craigyjp/trilogy-programmer/Photos/20190617_203137.jpg

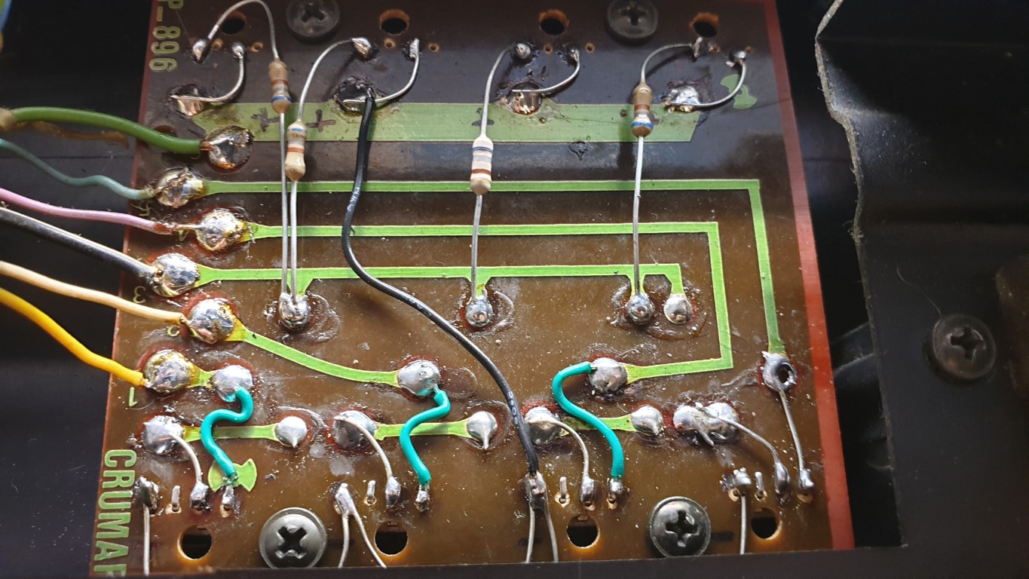
Photos/20190617_203137.jpg
