craigyjp/trilogy-programmer/Photos/20190617_203951.jpg

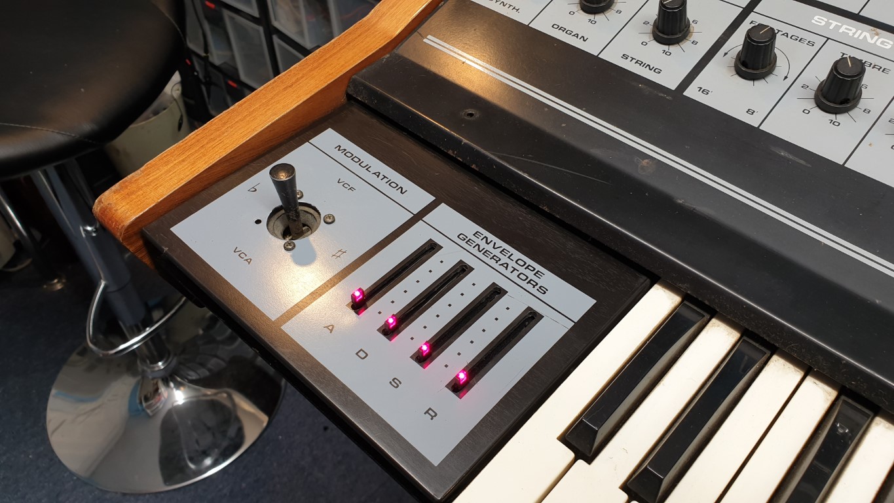
Photos/20190617_203951.jpg
