craigyjp/trilogy-programmer/Photos/20190617_203955.jpg

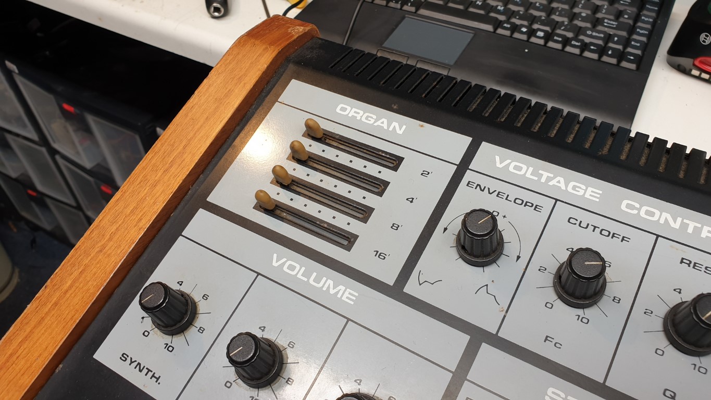
Photos/20190617_203955.jpg
