craigyjp/trilogy-programmer/Photos/20190617_230152.jpg

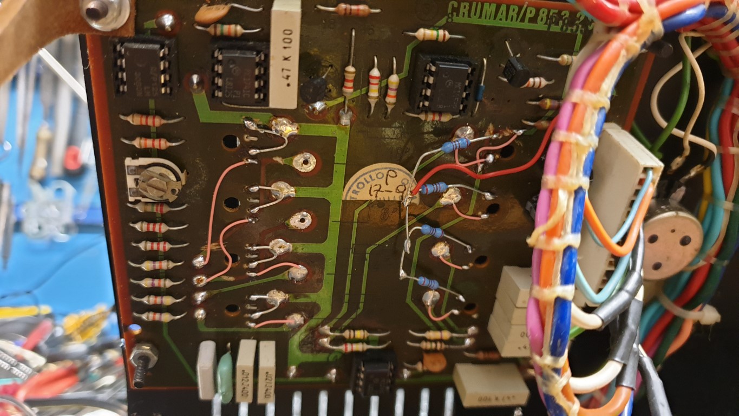
Photos/20190617_230152.jpg
