craigyjp/trilogy-programmer/Photos/20190617_230740.jpg

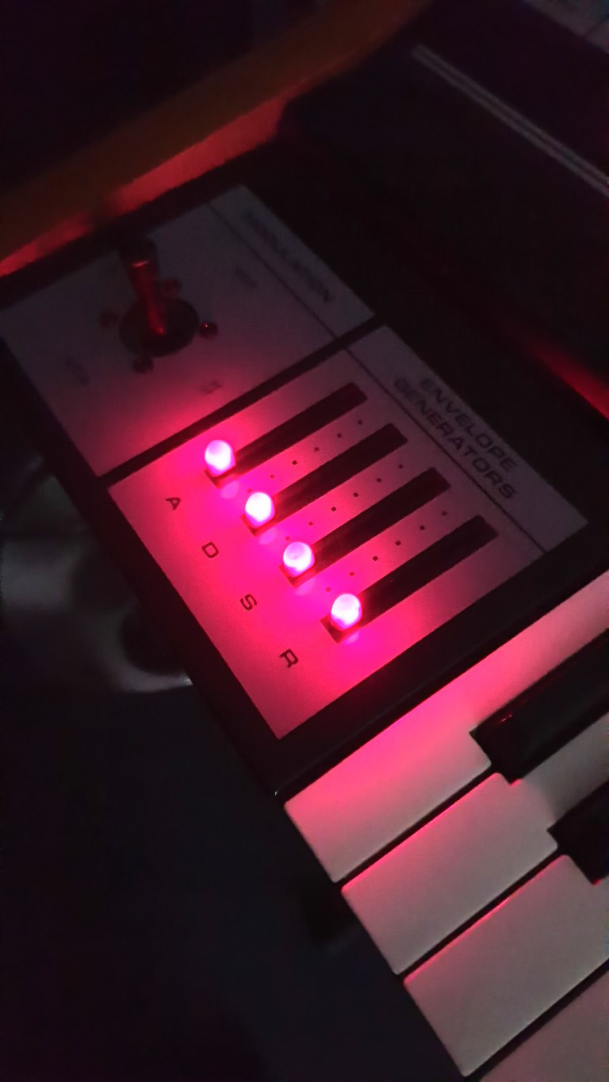
Photos/20190617_230740.jpg
