craigyjp/trilogy-programmer/Photos/20201019_152127.jpg

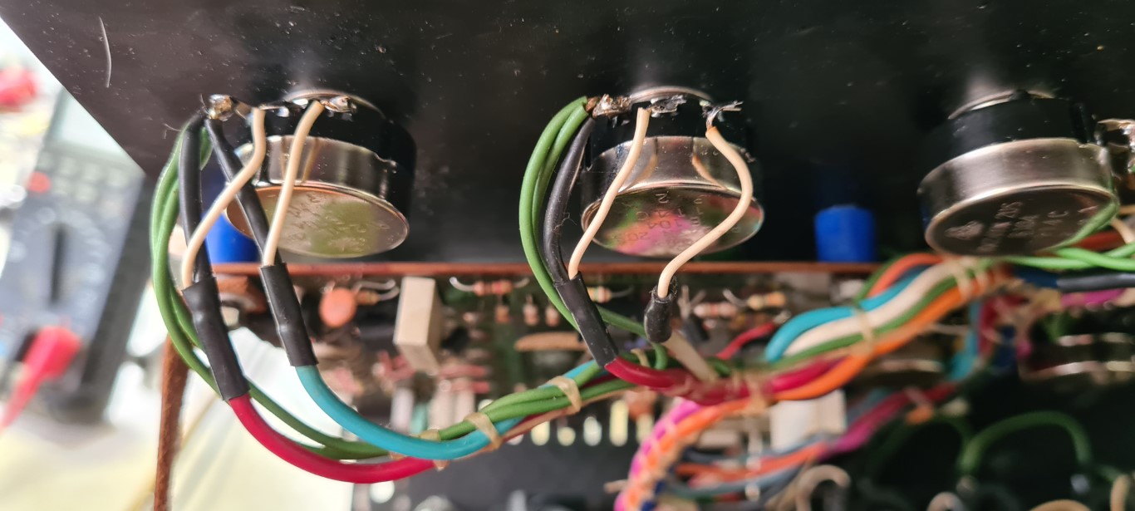
Photos/20201019_152127.jpg
