craigyjp/trilogy-programmer/Photos/20230502_165829.jpg

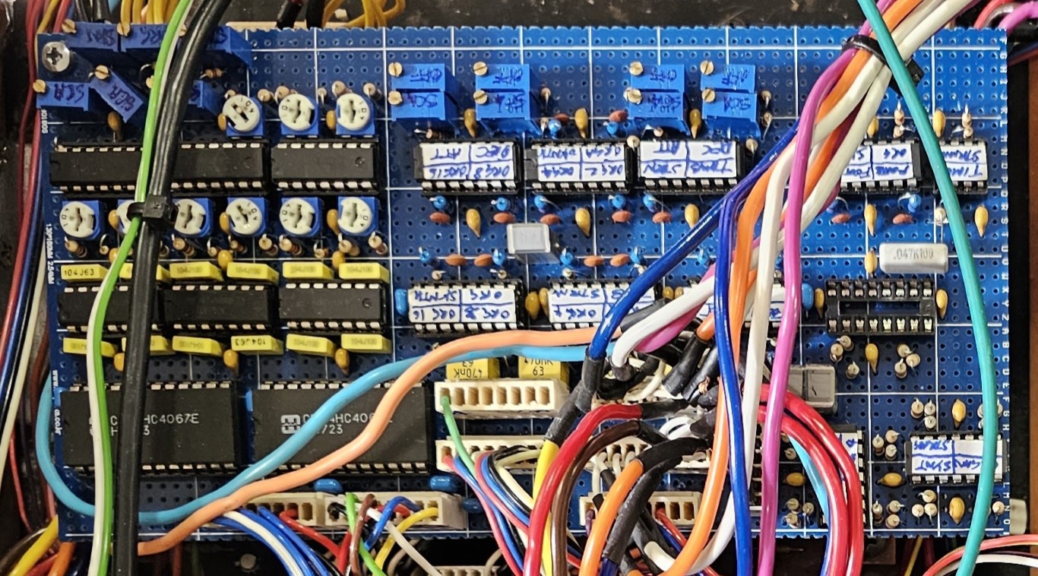
Photos/20230502_165829.jpg
