craigyjp/trilogy-programmer/Photos/20230504_145006.jpg

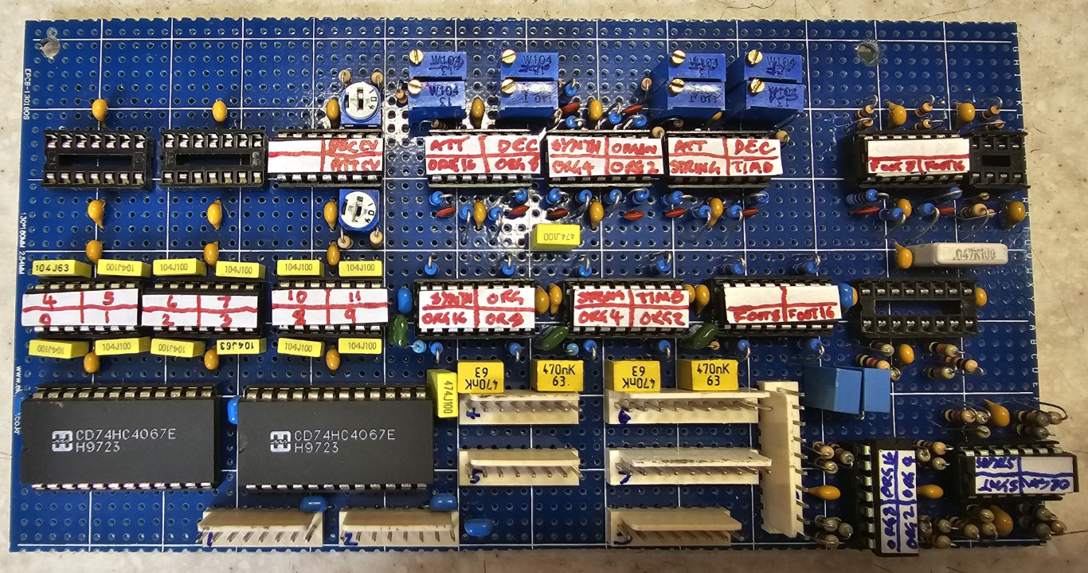
Photos/20230504_145006.jpg
