craigyjp/trilogy-programmer/Photos/20230504_152907.jpg

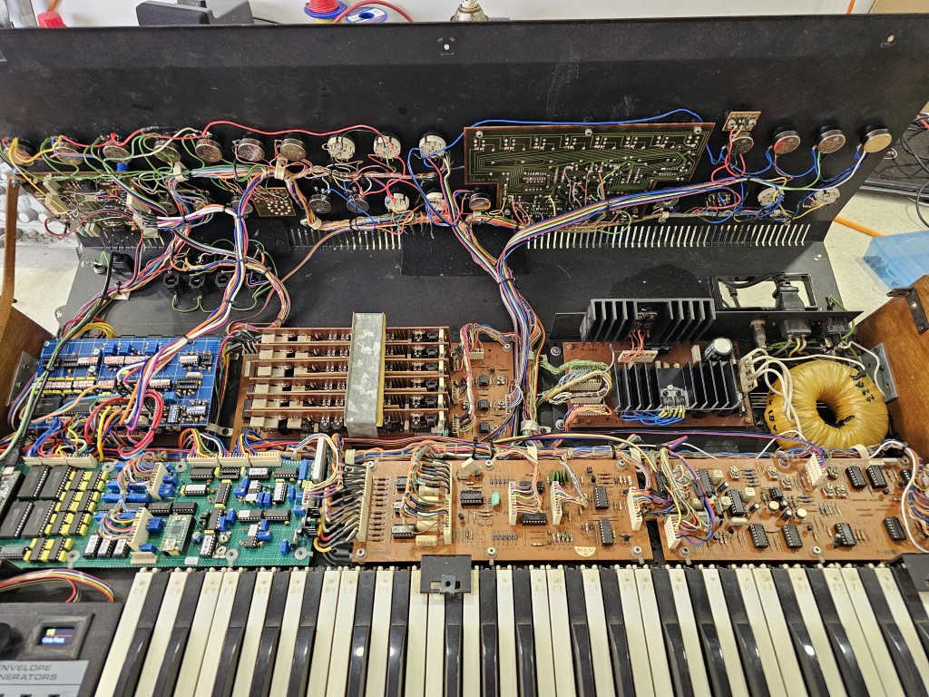
Photos/20230504_152907.jpg
