craigyjp/trilogy-programmer/Photos/20230506_184149.jpg

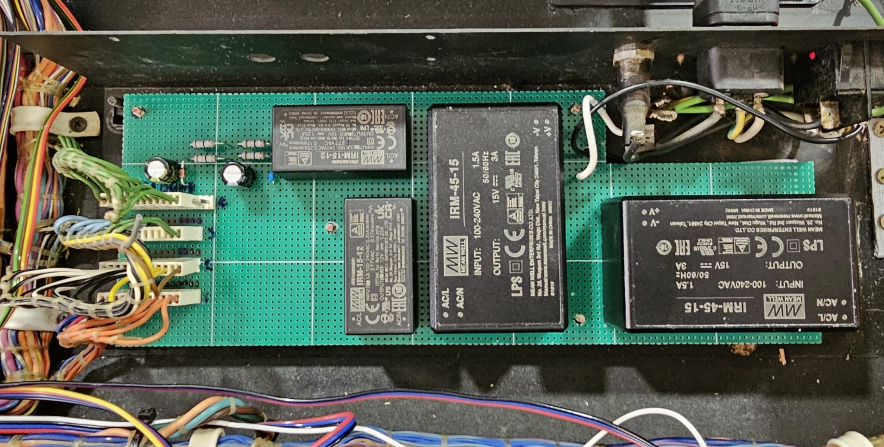
Photos/20230506_184149.jpg
