craigyjp/trilogy-programmer/Photos/20231115_115613.jpg

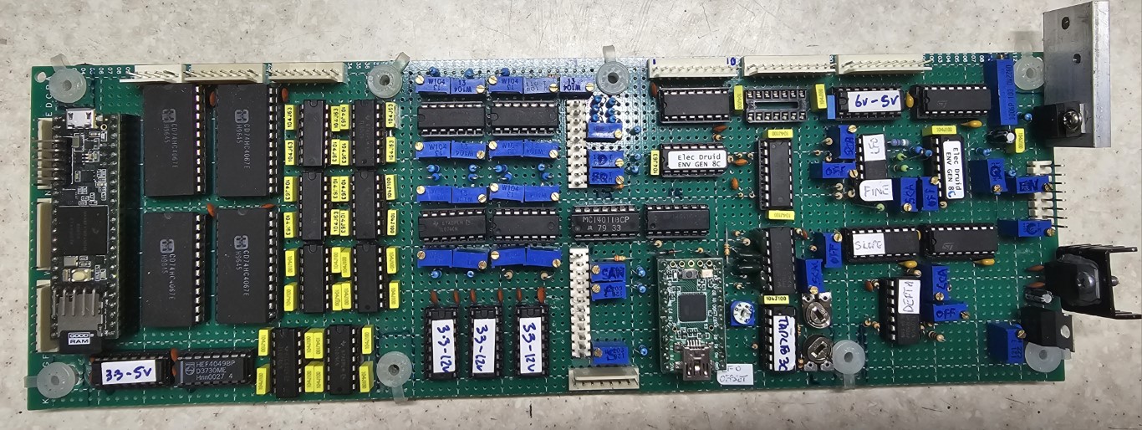
Photos/20231115_115613.jpg
