craigyjp/trilogy-programmer/Photos/20231115_134239.jpg

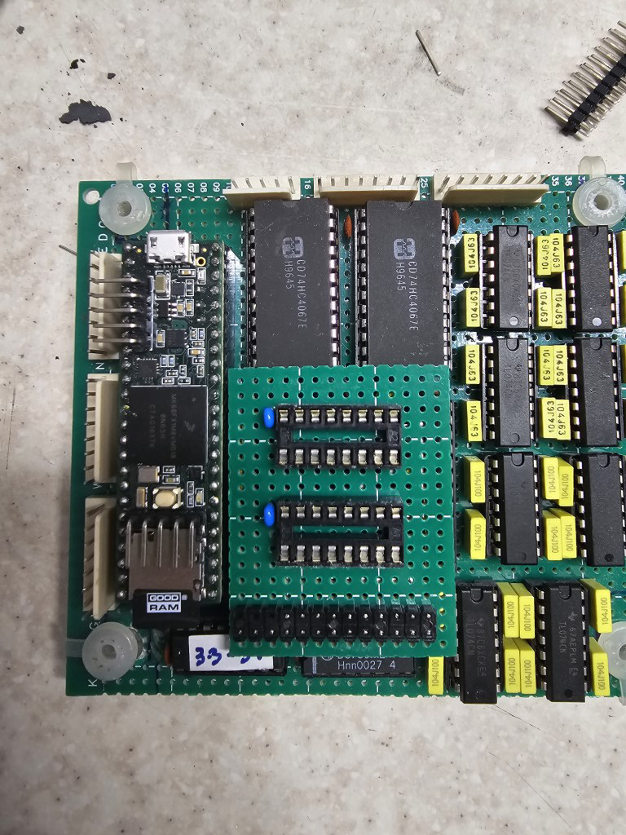
Photos/20231115_134239.jpg
