craigyjp/trilogy-programmer/Photos/20231115_134432.jpg

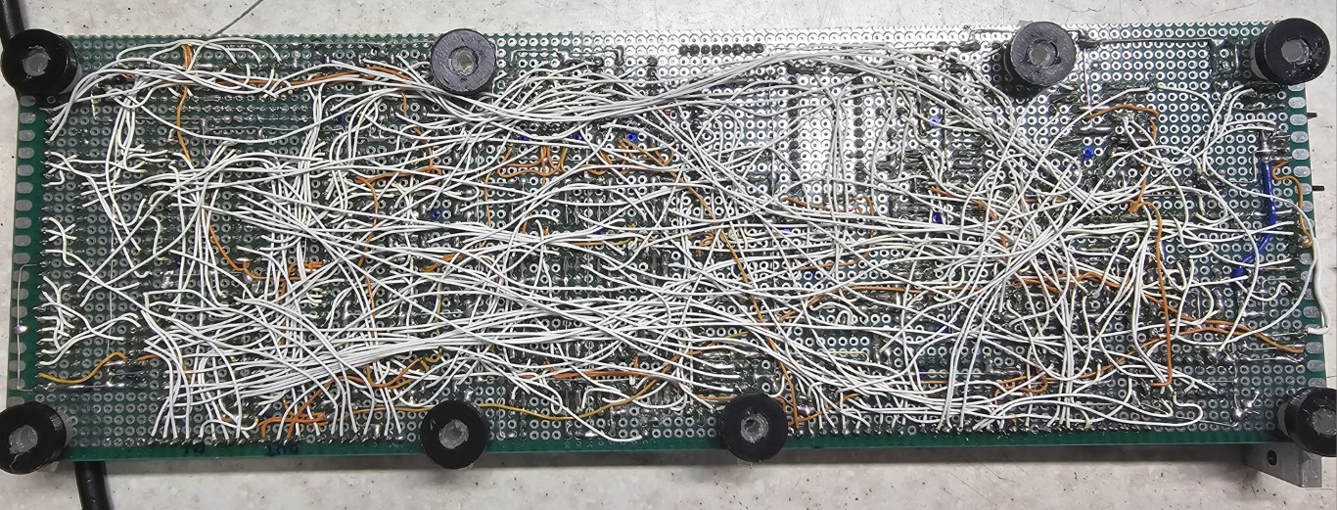
Photos/20231115_134432.jpg
