craigyjp/trilogy-programmer/Photos/20231115_145547.jpg

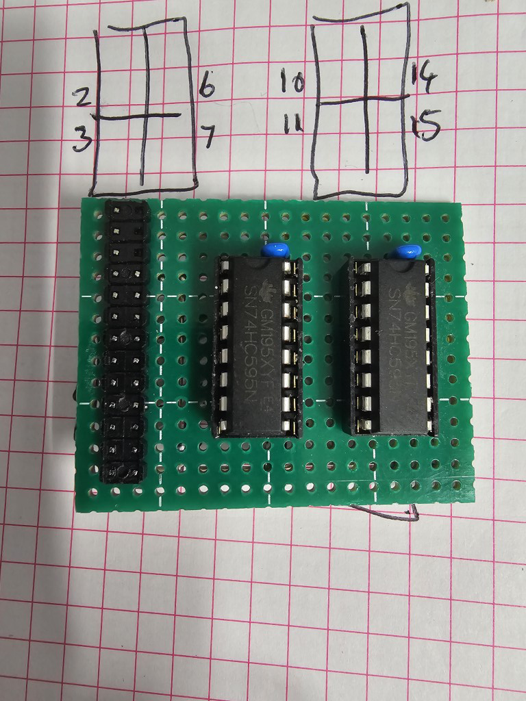
Photos/20231115_145547.jpg
