craigyjp/trilogy-programmer/Photos/20231115_145554.jpg

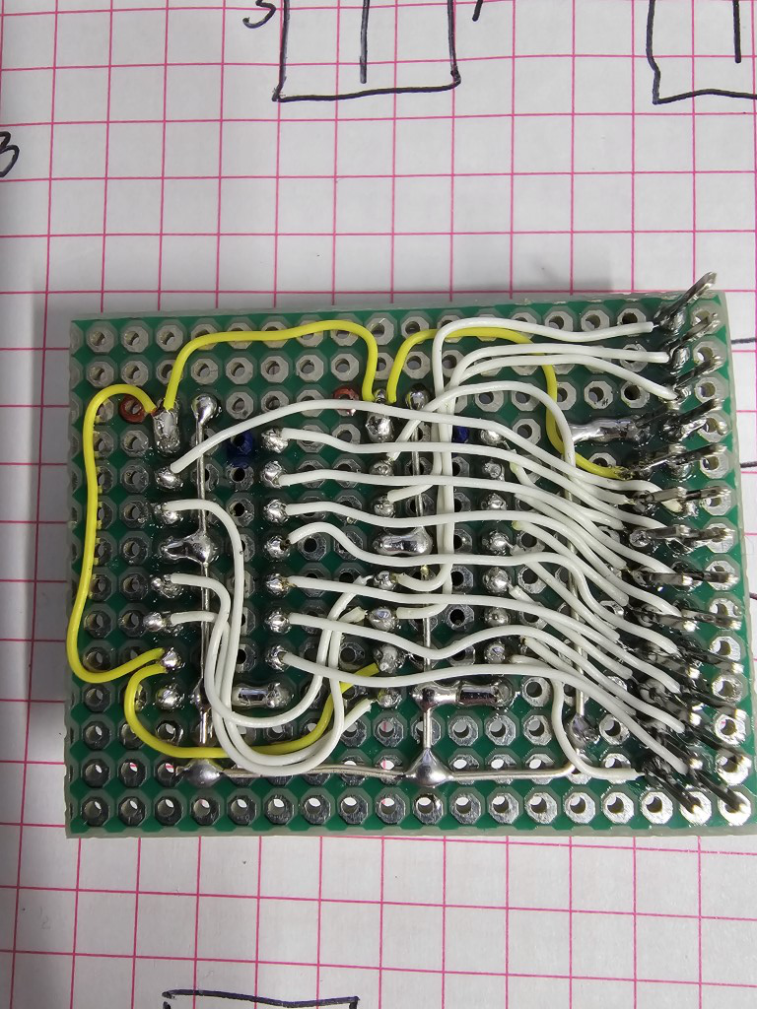
Photos/20231115_145554.jpg
