craigyjp/trilogy-programmer/Photos/20231115_162705.jpg

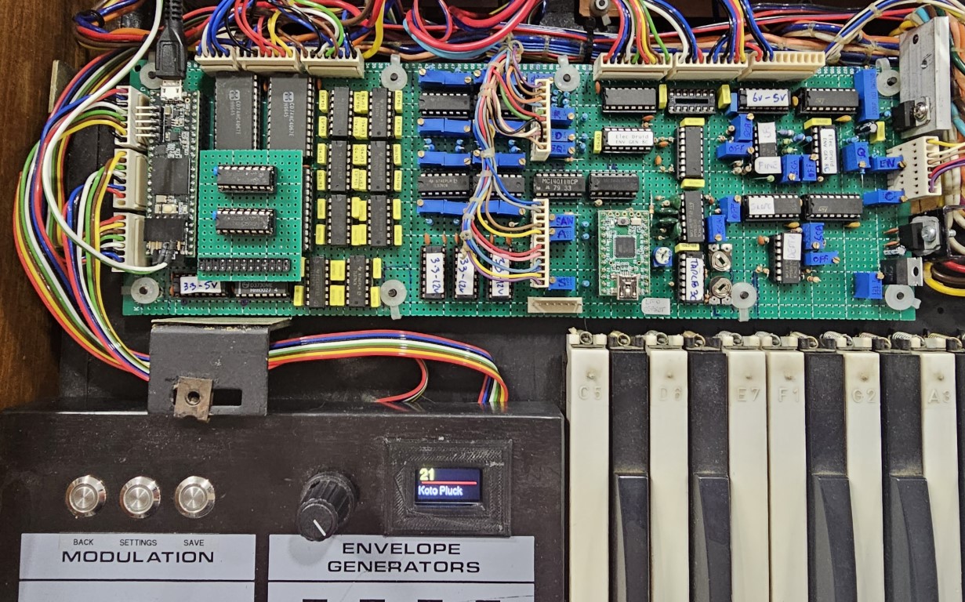
Photos/20231115_162705.jpg
