craigyjp/trilogy-programmer/Photos/20231116_115114.jpg

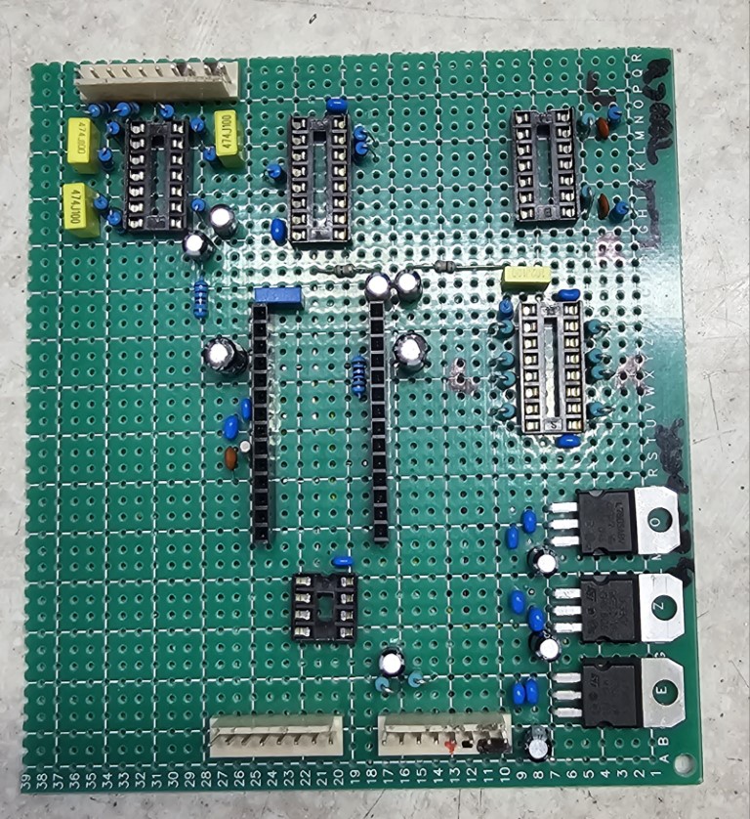
Photos/20231116_115114.jpg
