craigyjp/trilogy-programmer/Photos/20231116_120008.jpg

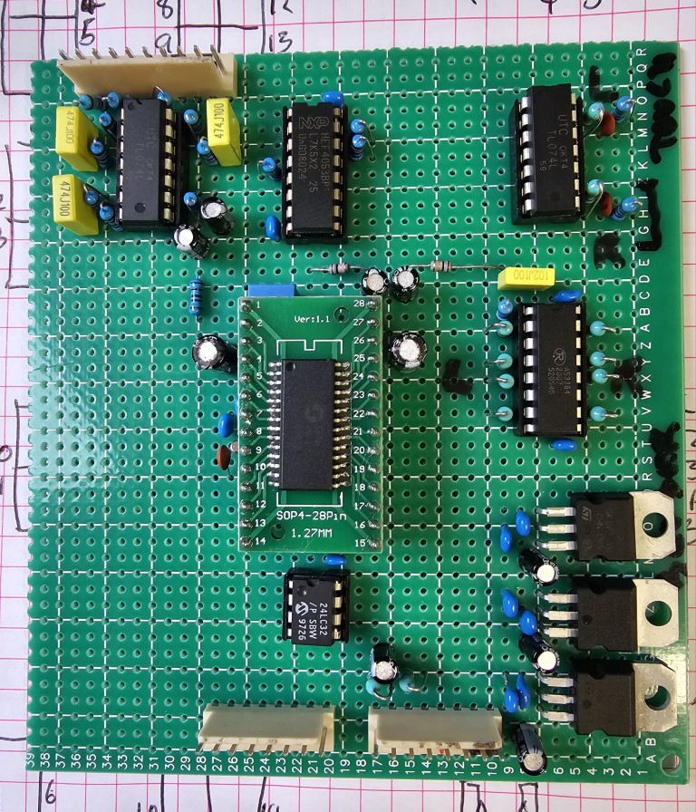
Photos/20231116_120008.jpg
