craigyjp/trilogy-programmer/Photos/20231116_120016.jpg

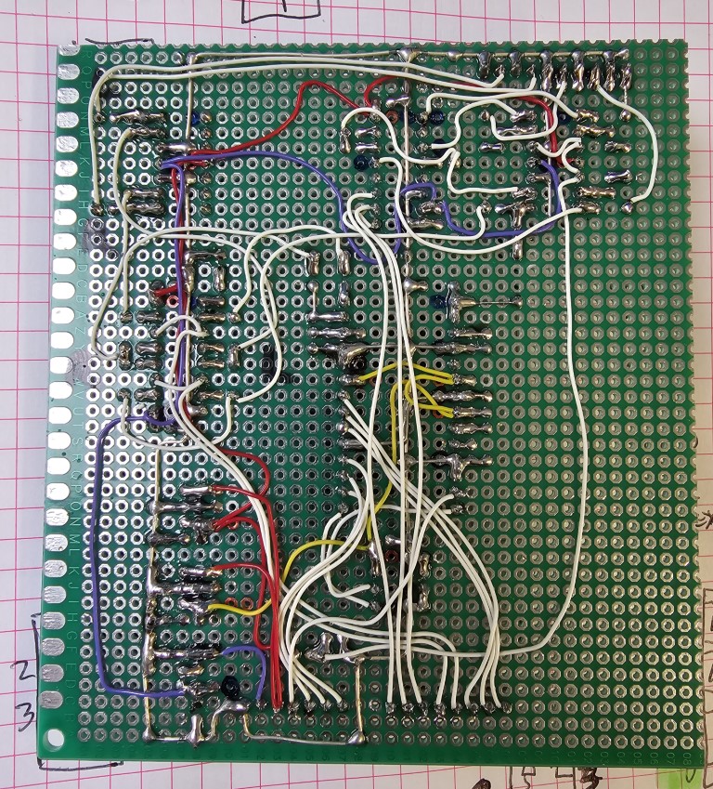
Photos/20231116_120016.jpg
