craigyjp/trilogy-programmer/Photos/FB_IMG_1599586812141.jpg

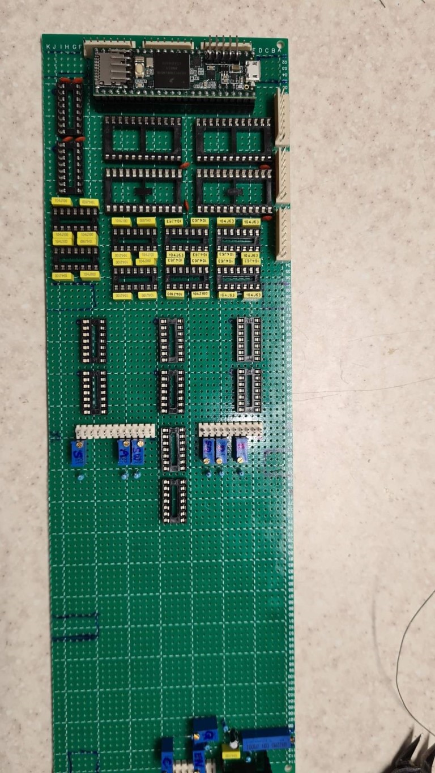
Photos/FB_IMG_1599586812141.jpg
