craigyjp/trilogy-programmer/Photos/FB_IMG_1599586822468.jpg

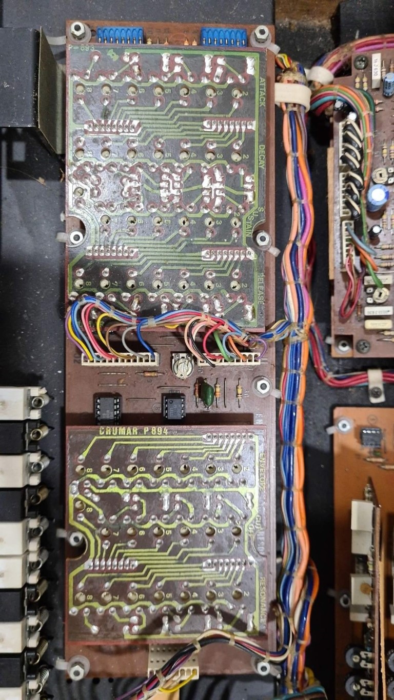
Photos/FB_IMG_1599586822468.jpg
