craigyjp/trilogy-programmer/Photos/FB_IMG_1599586833875.jpg

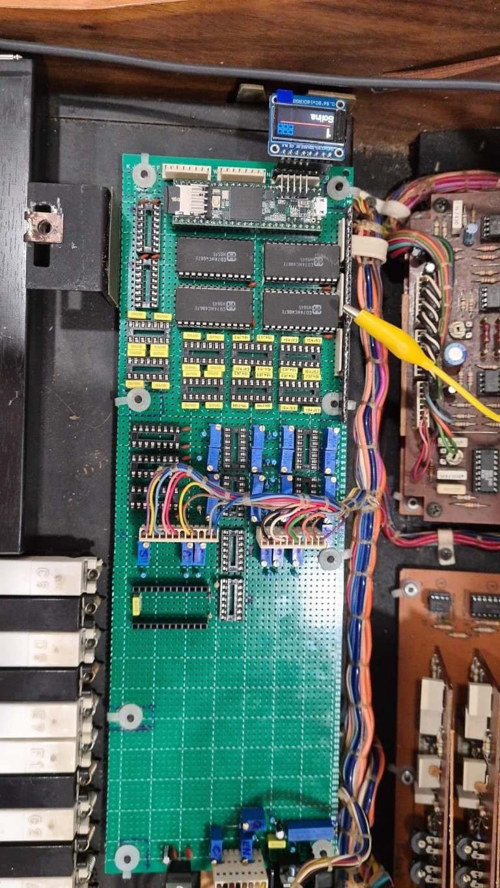
Photos/FB_IMG_1599586833875.jpg
