craigyjp/trilogy-programmer/Photos/IMG-20200920-WA0000.jpg

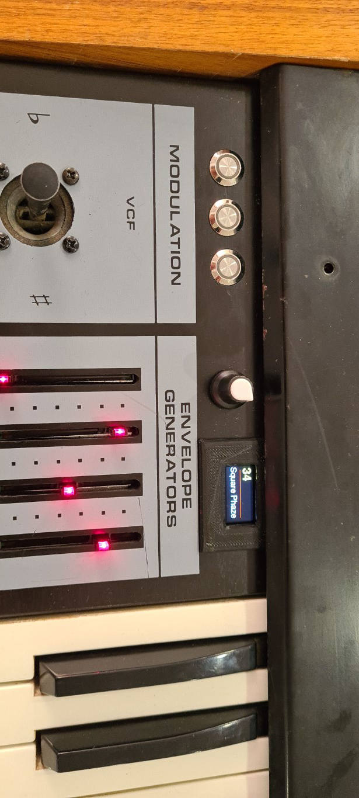
Photos/IMG-20200920-WA0000.jpg
