craigyjp/trilogy-programmer/Photos/IMG-20200920-WA0004.jpg

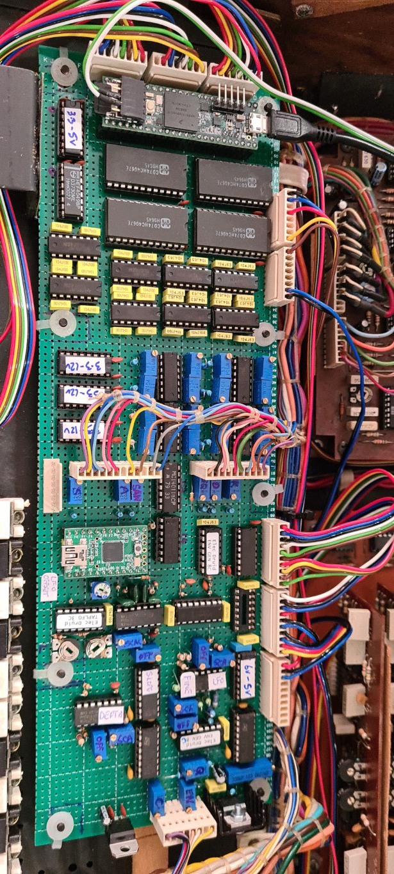
Photos/IMG-20200920-WA0004.jpg
