craigyjp/trilogy-programmer/Photos/trilogy4.jpg

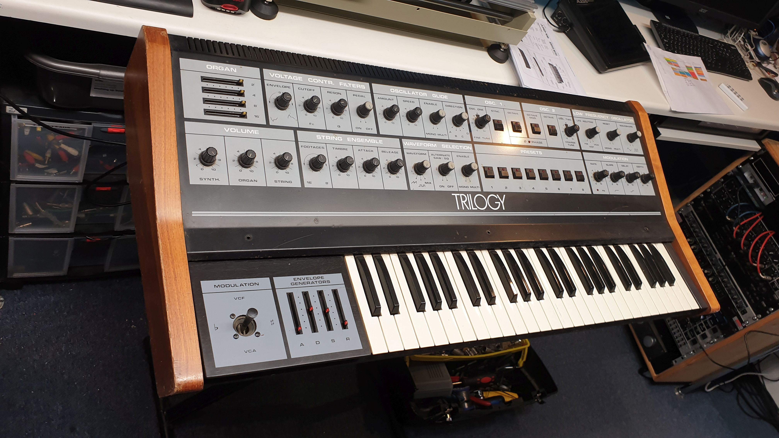
Photos/trilogy4.jpg
