craigyjp/trilogy-programmer/schematics/Effects Board.pdf

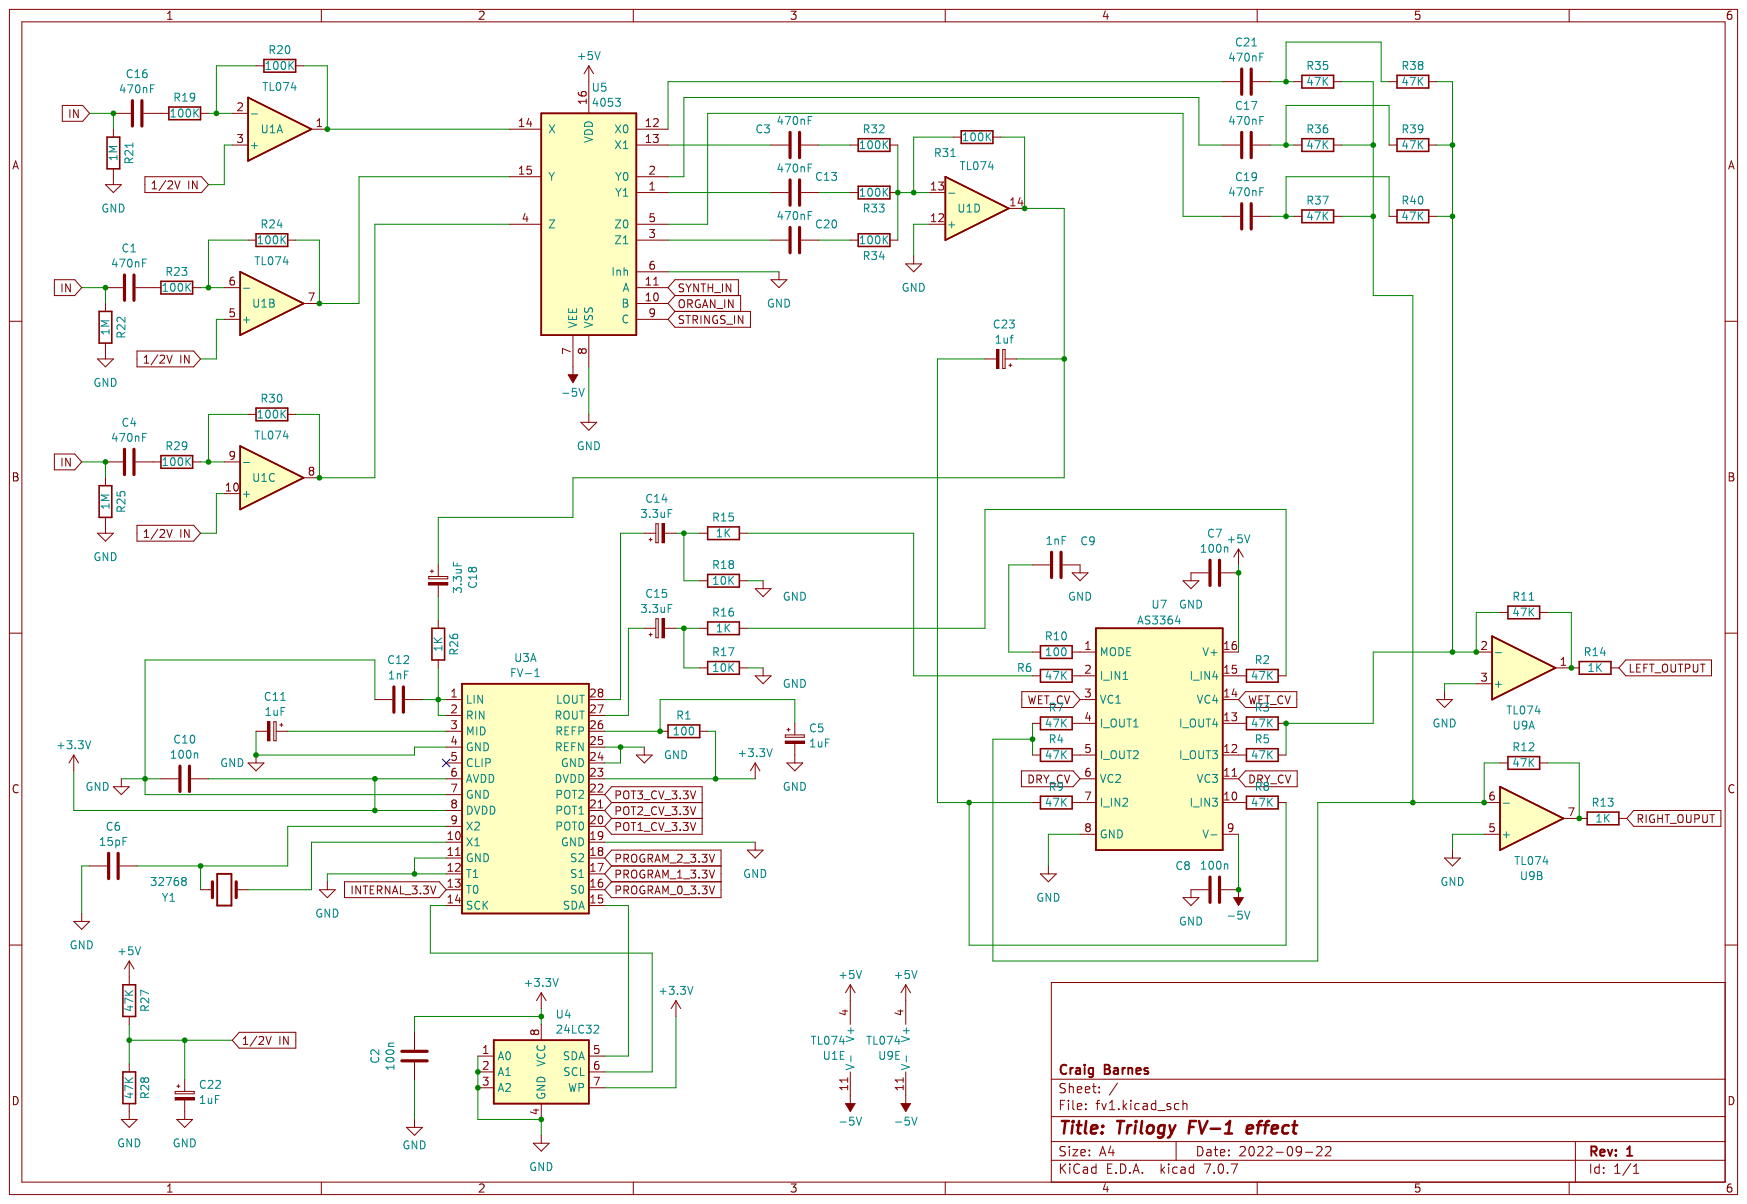
[picture p27: page 1]
