craigyjp/trilogy-programmer/(commit log)

2023-05-15 Updated the code recently to fix issues
    This is a refresh of the code from 3 years ago, I modded some of the hardware and now it needs new code to support it.
    Everything still works as it should but it is less noisy.
    [EepromMgr.h, HWControls.h, Parameters.h, ST7735Display.h, Trilogy.ino]
2023-11-26 Added effects board
